burrocargado/toshiba-aircon-mqtt-bridge/schematic/KiCad/aircon_controll.png

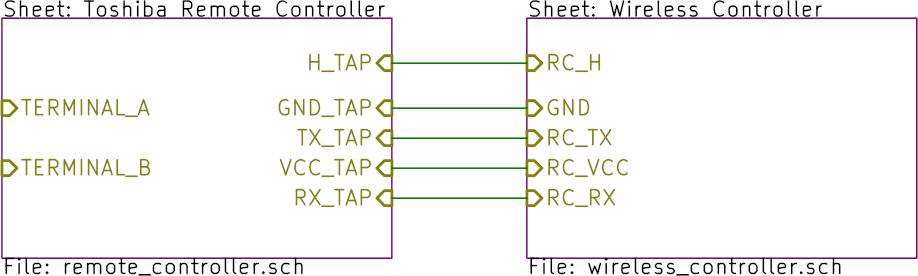
schematic/KiCad/aircon_controll.png
