burrocargado/toshiba-aircon-mqtt-bridge/schematic/KiCad/remote_controller.sch

## KiCad design schematic/KiCad/remote_controller.sch (2022-07-18)

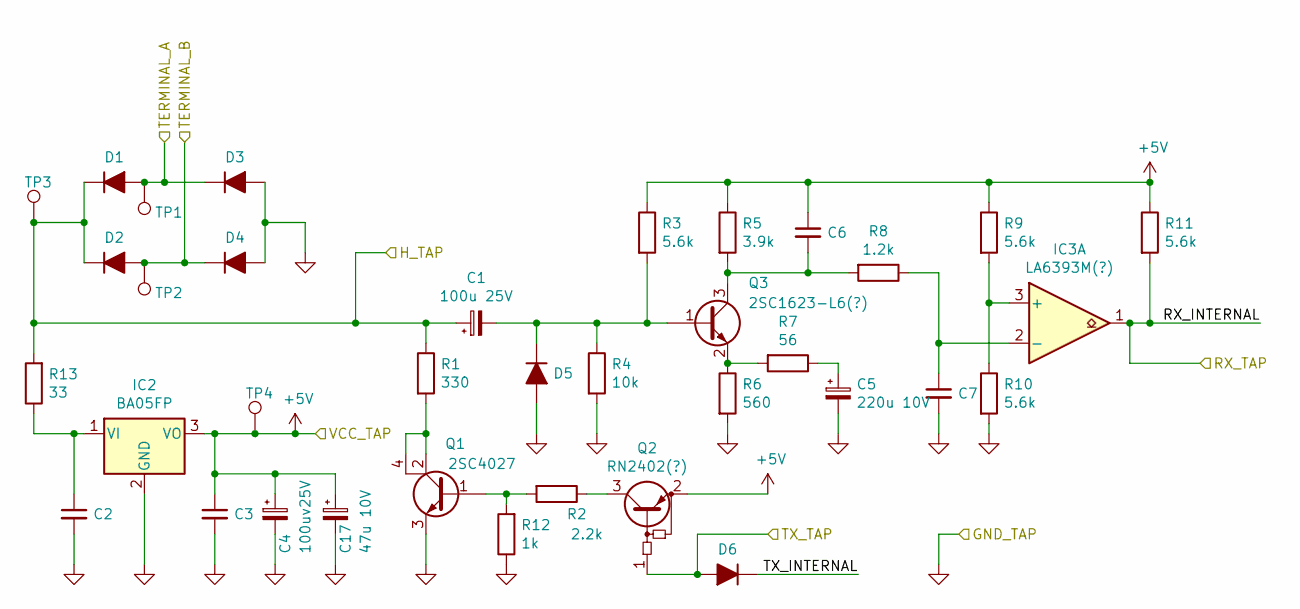
[picture p4: schematic remote_controller.sch]

Parts:
C1: 100u 25V
C2, C3, C6, C7: C_Small
C4: 100uv25V
C5: 220u 10V
C17: 47u 10V
D1, D2, D3, D4, D5, D6: D_ALT
IC2: BA05FP; TO-252-2
IC3: LA6393M(?)
Q1: 2SC4027
Q2: RN2402(?)
Q3: 2SC1623-L6(?)
R1: 330
R2: 2.2k
R3, R9, R10, R11: 5.6k
R4: 10k
R5: 3.9k
R6: 560
R7: 56
R8: 1.2k
R12: 1k
R13: 33
TP1, TP2, TP3, TP4: TestPoint

Connections:
+5V: C3.1, C4.1, C6.1, C17.1, IC2.3 (VO), Q2.2 (E), R3.1, R5.1, R9.1, R11.1, TP4.1
GND: C2.2, C3.2, C4.2, C5.2, C7.2, C17.2, D3.2 (A), D4.2 (A), D5.2 (A), IC2.2 (GND), Q1.3 (E), R4.2, R6.2, R10.2, R12.1
H_TAP: C1.1, D1.1 (K), D2.1 (K), R1.1, R13.2, TP3.1
unnamed: C1.2, D5.1 (K), Q3.1 (B), R3.2, R4.1
unnamed: C2.1, IC2.1 (VI), R13.1
unnamed: C5.1, R7.1
unnamed: C6.2, Q3.3 (C), R5.2, R8.2
unnamed: C7.1, IC3.2 (-), R8.1
unnamed: IC3.3 (+), R9.2, R10.1
unnamed: Q1.1 (B), R2.2, R12.2
unnamed: Q1.2 (C), Q1.4 (C), R1.2
unnamed: Q2.3 (C), R2.1
unnamed: Q3.2 (E), R6.1, R7.2
RX_INTERNAL: IC3.1, R11.2
TERMINAL_A: D1.2 (A), D3.1 (K), TP1.1
TERMINAL_B: D2.2 (A), D4.1 (K), TP2.1
TX_INTERNAL: D6.1 (K)
TX_TAP: D6.2 (A), Q2.1 (B)
