burrocargado/toshiba-aircon-mqtt-bridge/schematic/KiCad/wireless_controller.sch

## KiCad design schematic/KiCad/wireless_controller.sch (2022-07-18)

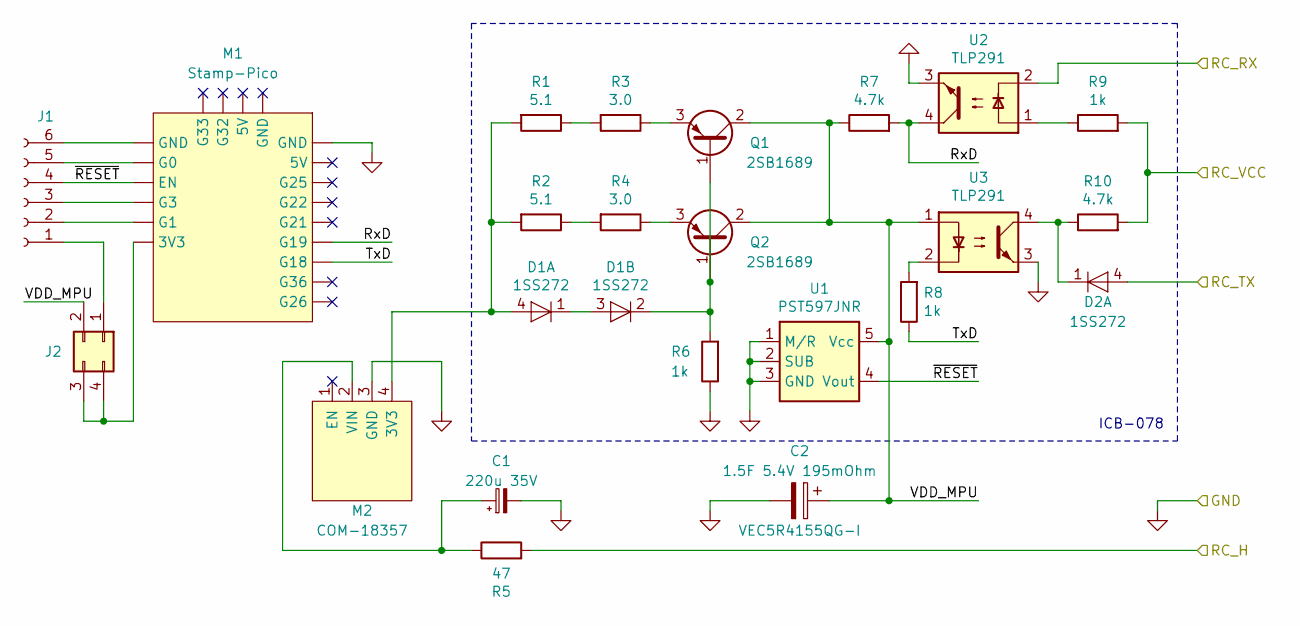
[picture p5: schematic wireless_controller.sch]

Parts:
C1: 220u 35V
C2: 1.5F 5.4V 195mOhm; PartNumber VEC5R4155QG-I
D1, D2: 1SS272
J1: Conn_01x06_Female
J2: Conn_02x02_Counter_Clockwise
M1: Stamp-Pico
M2: COM-18357
Q1, Q2: 2SB1689
R1, R2: 5.1
R3, R4: 3.0
R5: 47
R6, R8, R9: 1k
R7, R10: 4.7k
U1: PST597JNR
U2, U3: TLP291; SOIC-4_4.55x2.6mm_P1.27mm

Connections:
GND: C1.2, C2.2, M1.~, M2.3 (GND), R6.1, U1.1 (M/R), U1.2 (SUB), U1.3 (GND), U2.3, U3.3
unnamed: C1.1, M2.2 (VIN), R5.1
unnamed: D1.1 (K1), D1.3 (A2)
unnamed: D1.2 (K2), Q1.1 (B), Q2.1 (B), R6.2
unnamed: D1.4 (A1), M2.4 (3V3), R1.2, R2.2
unnamed: D2.1 (K1), R10.1, U3.4
unnamed: J1.1, J2.1
unnamed: J1.2, M1.~
unnamed: J1.3, M1.~
unnamed: J1.5, M1.~
unnamed: J1.6, M1.~
unnamed: J2.3, J2.4, M1.~
unnamed: Q1.3 (E), R3.1
unnamed: Q2.3 (E), R4.1
unnamed: R1.1, R3.2
unnamed: R2.1, R4.2
unnamed: R8.2, U3.2
unnamed: R9.1, U2.1
RC_H: R5.2
RC_RX: U2.2
RC_TX: D2.4 (A1)
RC_VCC: R9.2, R10.2
RxD: M1.~, R7.2, U2.4
TxD: M1.~, R8.1
VDD_MPU: C2.1, J2.2, Q1.2 (C), Q2.2 (C), R7.1, U1.5 (Vcc), U3.1
~RESET: J1.4, M1.~, U1.4 (Vout)

Notes on the sheet:
ICB-078
