burrocargado/toshiba-aircon-mqtt-bridge/(threads)

Thread 1 (2023-09-19):

Understanding Communication

mgoeller, 2023-09-19:
Hi

I read your blogpost and have some general understanding questions:

1. What is the advantage of connecting the ESP32 to the internal receiving circuit of the wired remote control instead of directly connecting to the AB line, as seen for example [here](https://github.com/issalig/toshiba_air_cond)?
2. For communication you need RX, TX, GND and VCC. So what is the purpose of H_TAP and RC_H?

Thank you and best regards
Malte

burrocargado, 2023-09-19:
Hello @mgoeller
Thank you for your interest.

1. The wired remote control has a circuit implemented to convert the received signal from the AB line to 5V serial and a circuit to drive the AB line from the logic signal to transmit, so I used that as is. Of course, it is possible to clone that circuit or make a circuit like [this](https://github.com/issalig/toshiba_air_cond) and configure it to interface with the ESP32 directly to the AB line, but I did not do that to save the cost of parts for that.
2. VCC is generated by a linear regulator inside the wired remote control. The average current consumption of the ESP32 (M5 Stamp Pico) is about 32mA at 5V power supply, so when connected to VCC of the wired remote control, the power supply current flowing from the AB line is also 32mA. The regulator generates (15V - 5V) x 32mA = 320mW of heat. It is not clear whether this heat generation is acceptable, and since the power supply capacity of the AB line is probably about 20 mA, it will be exceeded. Therefore, instead of a linear regulator, I use a switching regulator which converts the voltage with minimal energy loss (~10%) to step down to 3.3V from H_TAP immediately after rectifying with a diode bridge from the AB line, so that the current from the AB line is as low as possible.

Does this answer your question? Please ask again if you have any questions.

Closed 2023-10-14.

Thread 2 (2023-11-02):

Communication

moustafamosalam, 2023-11-02:
Hey, I have an esp32 S3 and I want to use it in this project, can you please help me and tell me what should I do exactly because I don't really understand what should be done?

burrocargado, 2023-11-03:
Due to the limited power supply capacity of the AB line, I chose M5Stack's STAMP-PICO module as an ESP32 module with no extra features such as USB-I/F and as low power consumption as possible.
This module is small in size and easy to handle because it contains only an ESP32-PICO-D4 chip, an antenna, and minimal peripheral circuitry such as a power supply regulator and an LED. The power regulator is unnecessary because I don't use it, but I still like it because it is smaller than other modules.

I haven't looked into ESP32 S3, so I don't know if it can be used for this project, but I think it can be used if it has Wi-Fi for MQTT and 2 serial lines for AB line sending/receiving and debugging, and if power consumption is not a problem.

If you want to reproduce this project, it might be faster to buy a STAMP-PICO or equivalent with an ESP32-PICO-D4 chip.
STAMP-PICO modules are available from Digi-Key or Mouser, so even if you don't have a local store that carries them, I think you can still get them.

Closed 2023-11-12.
