burrocargado/toshiba-aircon-mqtt-bridge/(commit log)

2022-07-21 Add: sending packet error status to mqtt broker
    [main.cpp]
2022-08-07 Use UART_MODE_RS485_HALF_DUPLEX for Serial2
2022-11-15 Add publishing MQTT connection status
    Use LWT with retained flag to announce that the bridge is dead.
    When the bridge connects to the broker, publish an alive message
    with retained flag to replace the LWT message.
    [main.cpp]
